ZhengXueTech/balance-toys/img/eagle-ar.jpg

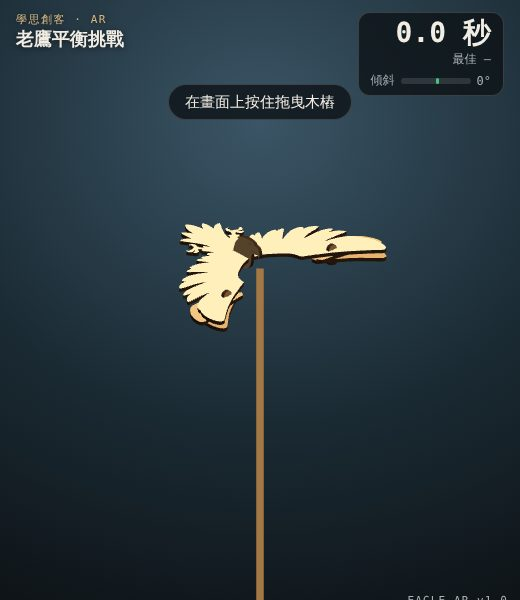
img/eagle-ar.jpg
