ZhengXueTech/balance-toys/eagle/ar_samples/eagle2_doodle.jpg

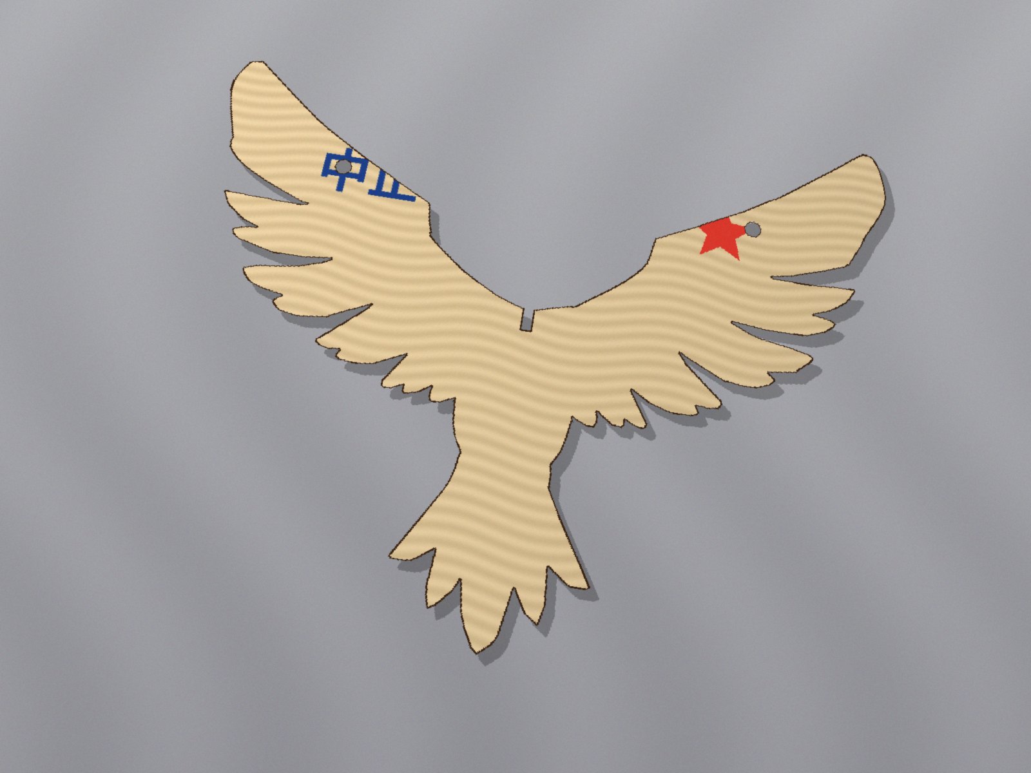
eagle/ar_samples/eagle2_doodle.jpg
