ZhengXueTech/balance-toys/eagle/ar_samples/eagle1_bald.jpg

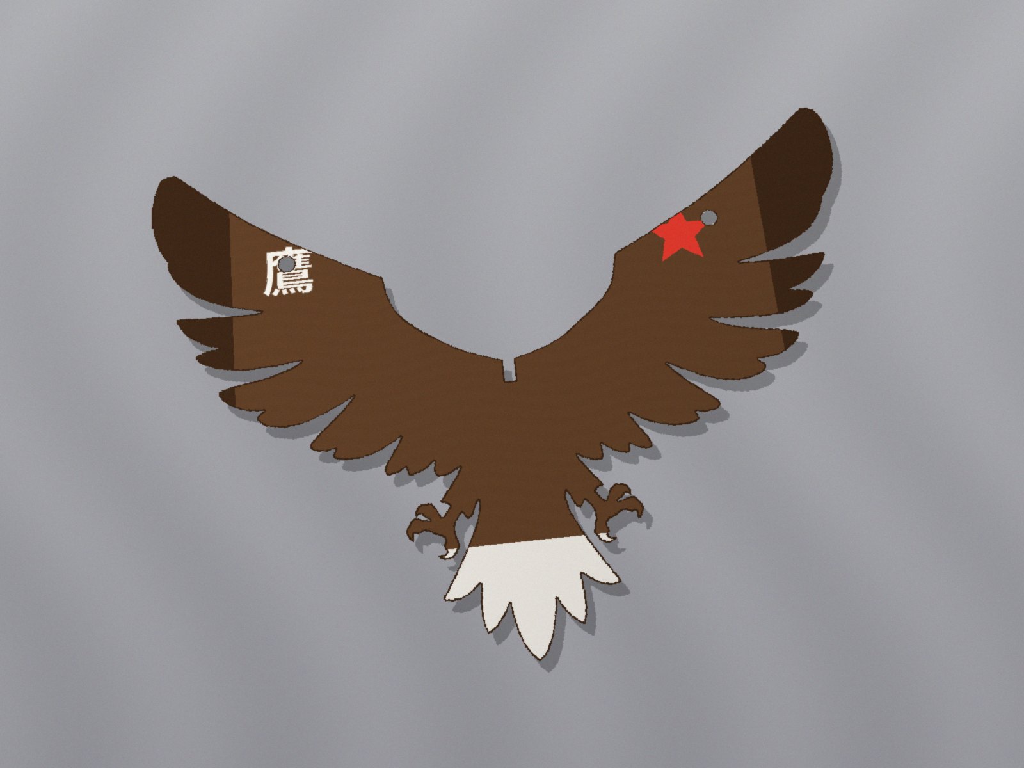
eagle/ar_samples/eagle1_bald.jpg
