ZhengXueTech/balance-toys/eagle/ar_samples/eagle1_doodle.jpg

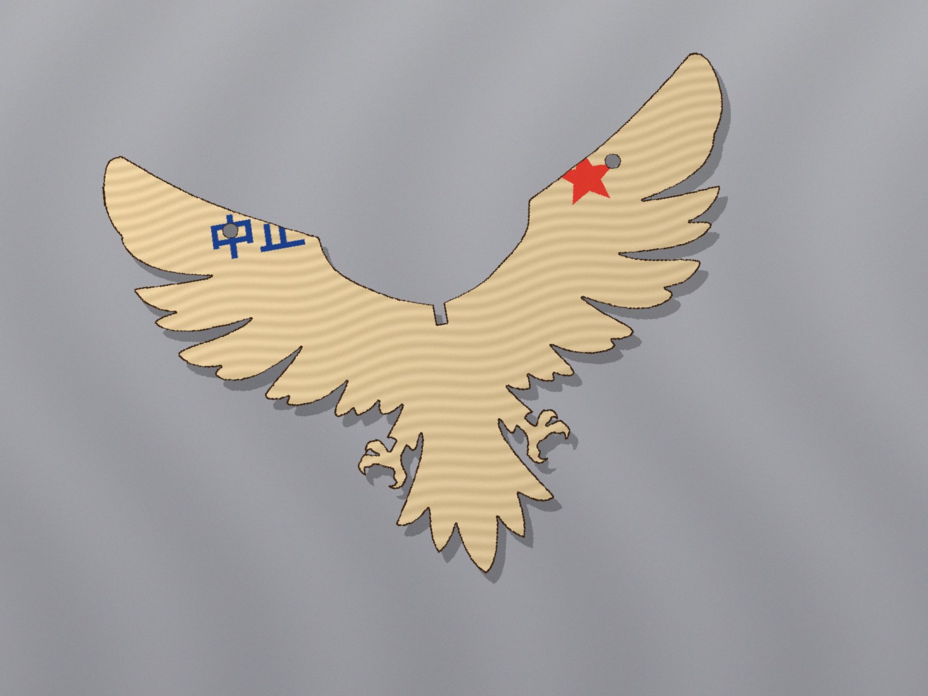
eagle/ar_samples/eagle1_doodle.jpg
