ZhengXueTech/balance-toys/eagle/ar_samples/eagle1_rainbow.jpg

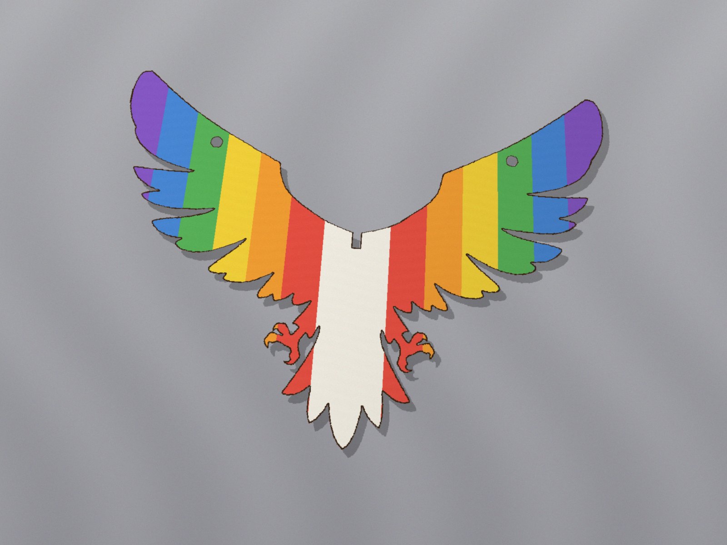
eagle/ar_samples/eagle1_rainbow.jpg
