ZhengXueTech/balance-toys/eagle/ar_samples/eagle2_magpie.jpg

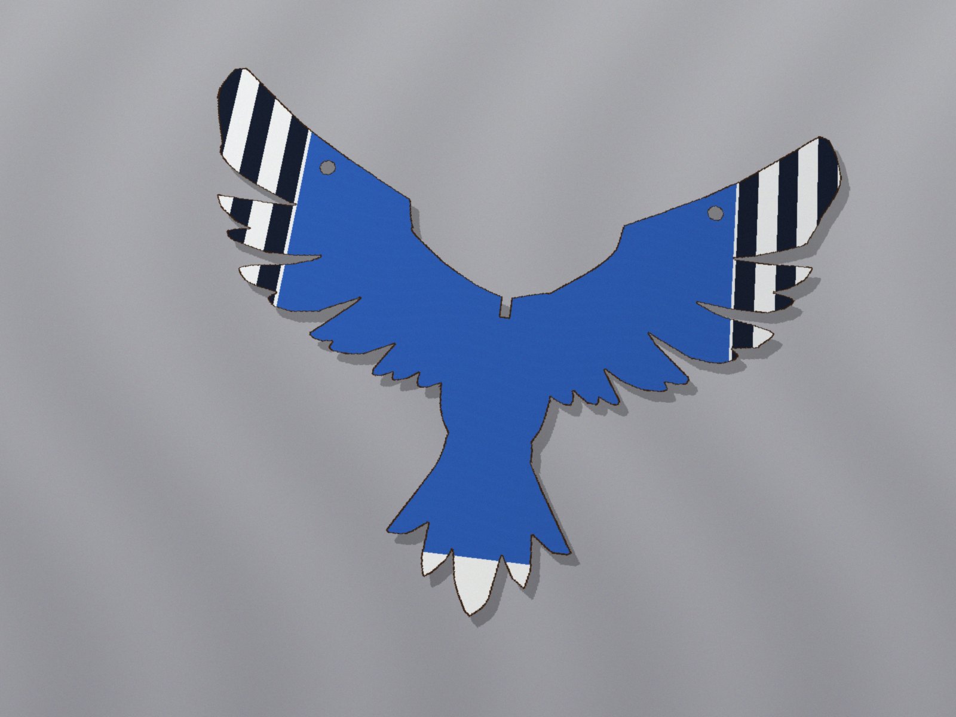
eagle/ar_samples/eagle2_magpie.jpg
