ZhengXueTech/balance-toys/eagle/ar_samples/eagle2_phoenix.jpg

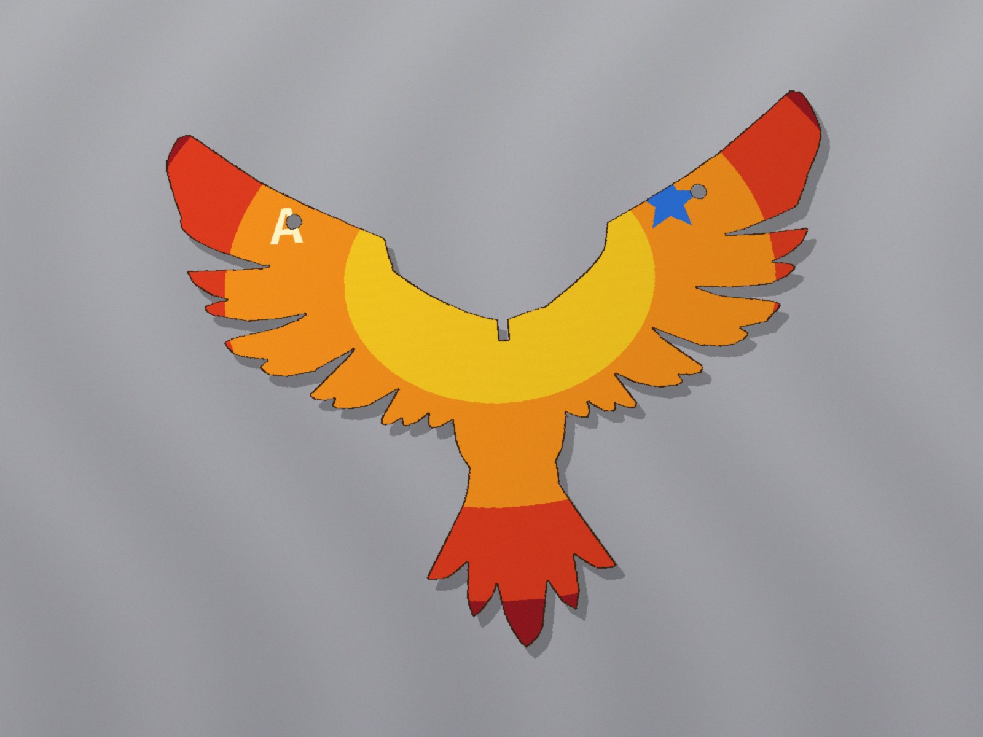
eagle/ar_samples/eagle2_phoenix.jpg
