ZhengXueTech/balance-toys/img/iss-lab.jpg

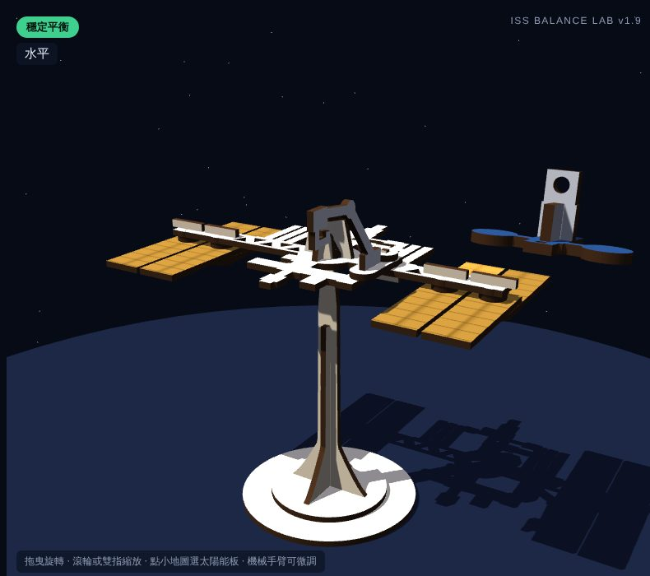
img/iss-lab.jpg
