ZhengXueTech/balance-toys/img/pelican2-lab.jpg

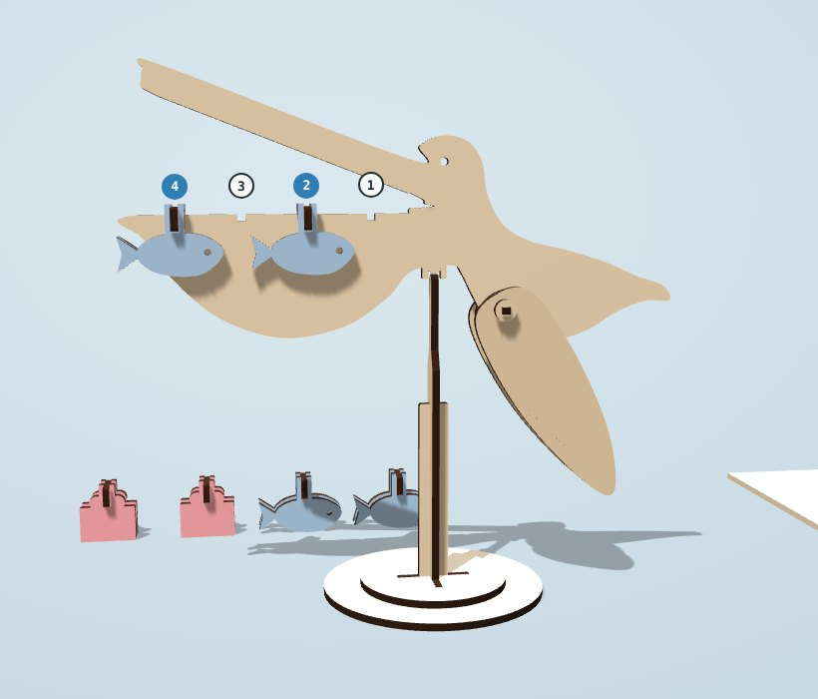
img/pelican2-lab.jpg
