ZhengXueTech/balance-toys/img/pelican-lab.jpg

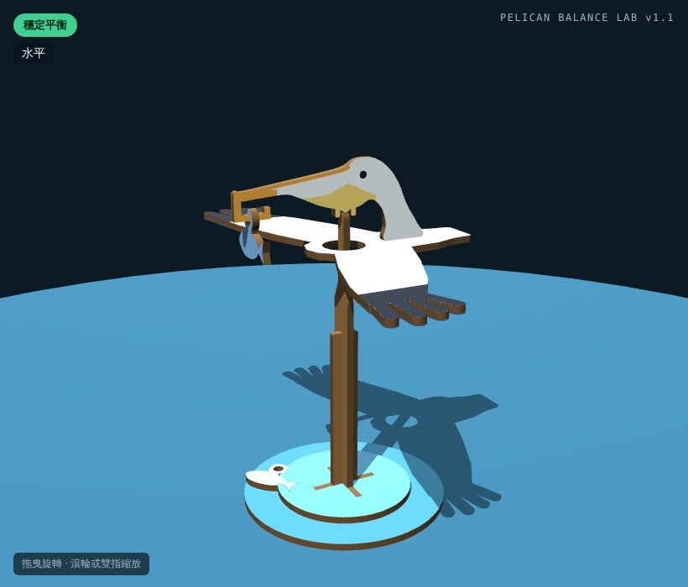
img/pelican-lab.jpg
