ZhengXueTech/balance-toys/eagle/files/Eagle2_prey_V2-5_board600x400_6sets_fishonly_laser.dxf

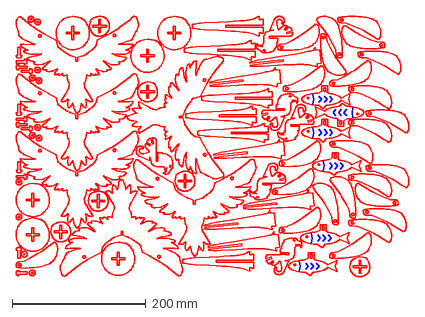
[picture p11: CAD file, 2026-11-08]
eagle/files/Eagle2_prey_V2-5_board600x400_6sets_fishonly_laser.dxf
588.4 x 389.9 mm
