ZhengXueTech/balance-toys/iss/files/ISS_v7_board600x400_4sets_laser.dxf

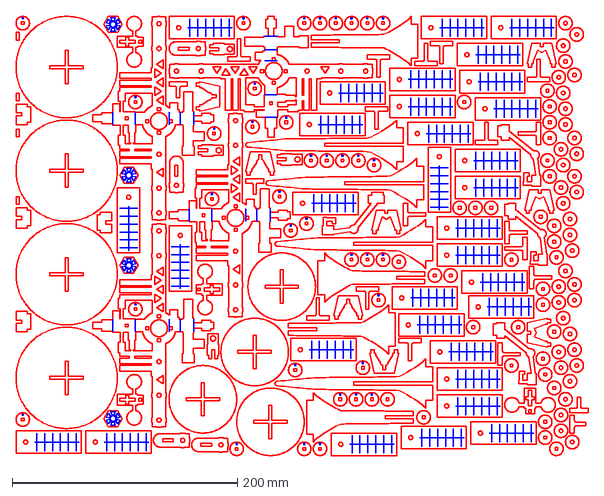
[picture p12: CAD file, 2026-11-01]
iss/files/ISS_v7_board600x400_4sets_laser.dxf
508.0 x 390.0 mm
