ZhengXueTech/balance-toys/pelican/files/Pelican2_v1.1_board600x400_4sets_laser.dxf

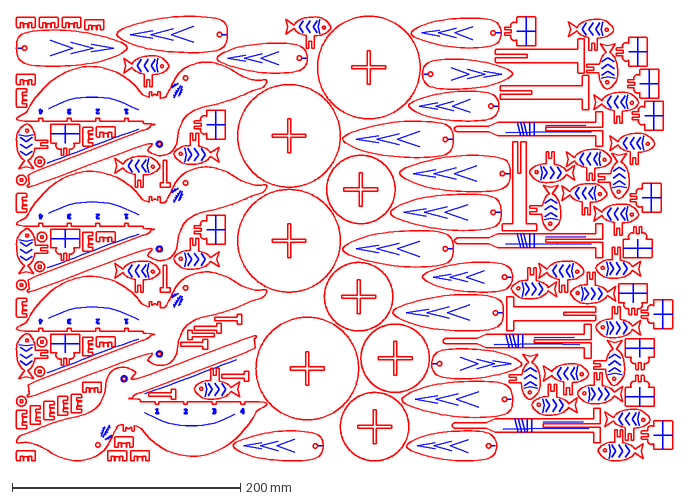
[picture p13: CAD file, 2026-11-01]
pelican/files/Pelican2_v1.1_board600x400_4sets_laser.dxf
575.2 x 390.0 mm
