ZhengXueTech/balance-toys/tools/Joint_test_comb_3mm_laser.dxf

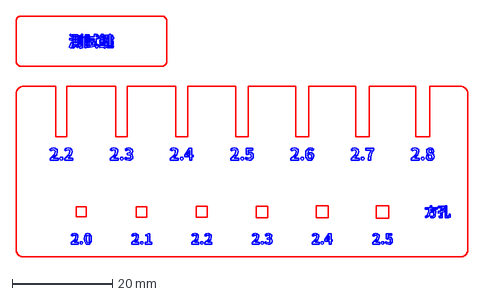
[picture p14: CAD file, 2026-11-08]
tools/Joint_test_comb_3mm_laser.dxf
90.0 x 48.0 mm
