ZhengXueTech/balance-toys/eagle/files/Eagle2_prey_V2-5_laser.dxf

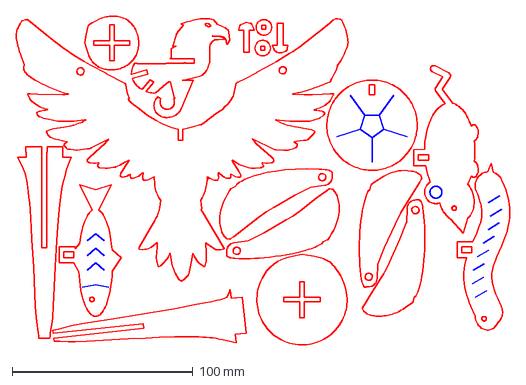
[picture p15: CAD file, 2026-11-08]
eagle/files/Eagle2_prey_V2-5_laser.dxf
272.9 x 181.7 mm
