ZhengXueTech/balance-toys/iss/files/ISS_v7_slot27_laser.dxf

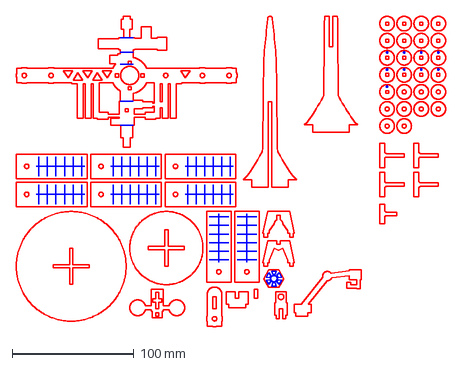
[picture p16: CAD file, 2026-10-27]
iss/files/ISS_v7_slot27_laser.dxf
352.0 x 254.5 mm
