ZhengXueTech/balance-toys/pelican/files/Pelican_v1.1_board600x400_6sets_laser.dxf

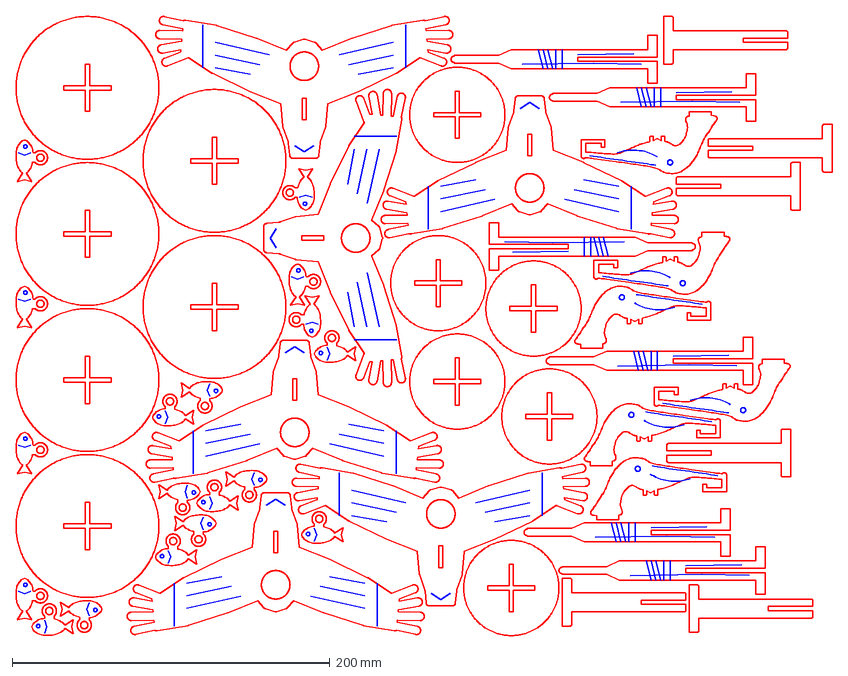
[picture p17: CAD file, 2026-11-01]
pelican/files/Pelican_v1.1_board600x400_6sets_laser.dxf
514.0 x 390.0 mm
