ZhengXueTech/balance-toys/pelican/files/Pelican2_v1.1_laser.dxf

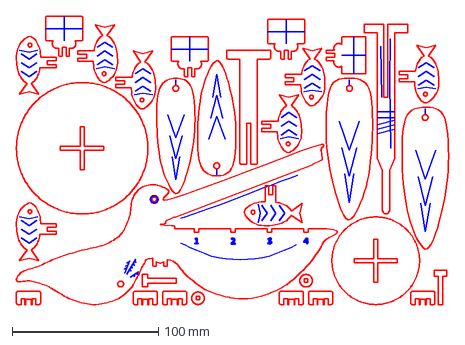
[picture p19: CAD file, 2026-11-01]
pelican/files/Pelican2_v1.1_laser.dxf
295.8 x 197.2 mm
