ZhengXueTech/balance-toys/eagle/files/Eagle2_prey_V2-4_board600x400_5sets_laser.dxf

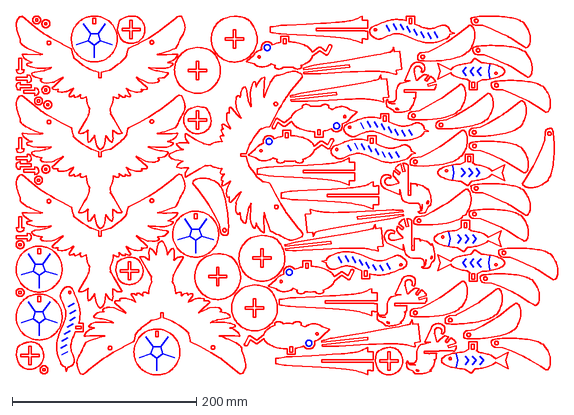
[picture p21: CAD file, 2026-11-01]
eagle/files/Eagle2_prey_V2-4_board600x400_5sets_laser.dxf
588.4 x 389.9 mm
