ZhengXueTech/balance-toys/pelican/files/Pelican_v1.1_slot27_laser.dxf

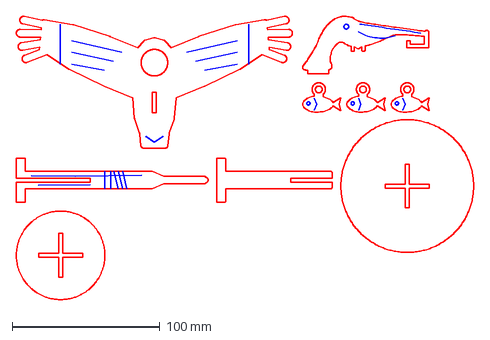
[picture p22: CAD file, 2026-10-27]
pelican/files/Pelican_v1.1_slot27_laser.dxf
310.0 x 192.0 mm
