ZhengXueTech/balance-toys/eagle/files/Eagle2_prey_V2-4_laser.dxf

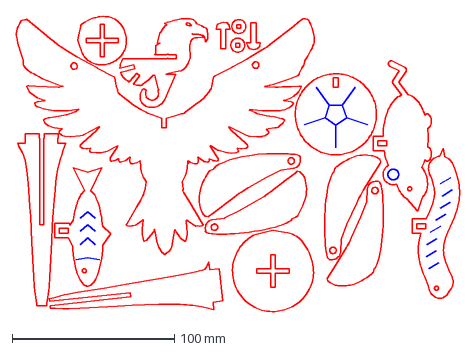
[picture p23: CAD file, 2026-10-29]
eagle/files/Eagle2_prey_V2-4_laser.dxf
272.9 x 181.7 mm
