ZhengXueTech/balance-toys/pelican/files/Pelican2_v1.0_laser.dxf

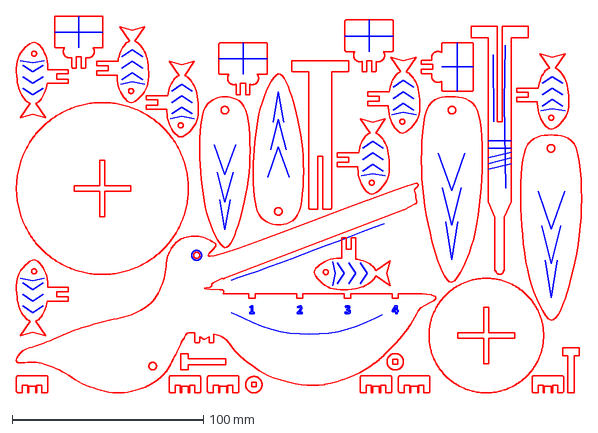
[picture p24: CAD file, 2026-11-01, an earlier design]
pelican/files/Pelican2_v1.0_laser.dxf
295.8 x 197.2 mm
