ZhengXueTech/balance-toys/eagle/files/Eagle2_prey_V2-5_cardboard_A3.pdf

## 老鷹平衡鳥 第二款 V2_5（卡榫再收緊）「老鷹抓獵物」（3 mm 板，老鷹 14 片＋獵物 4 片，全木頭）

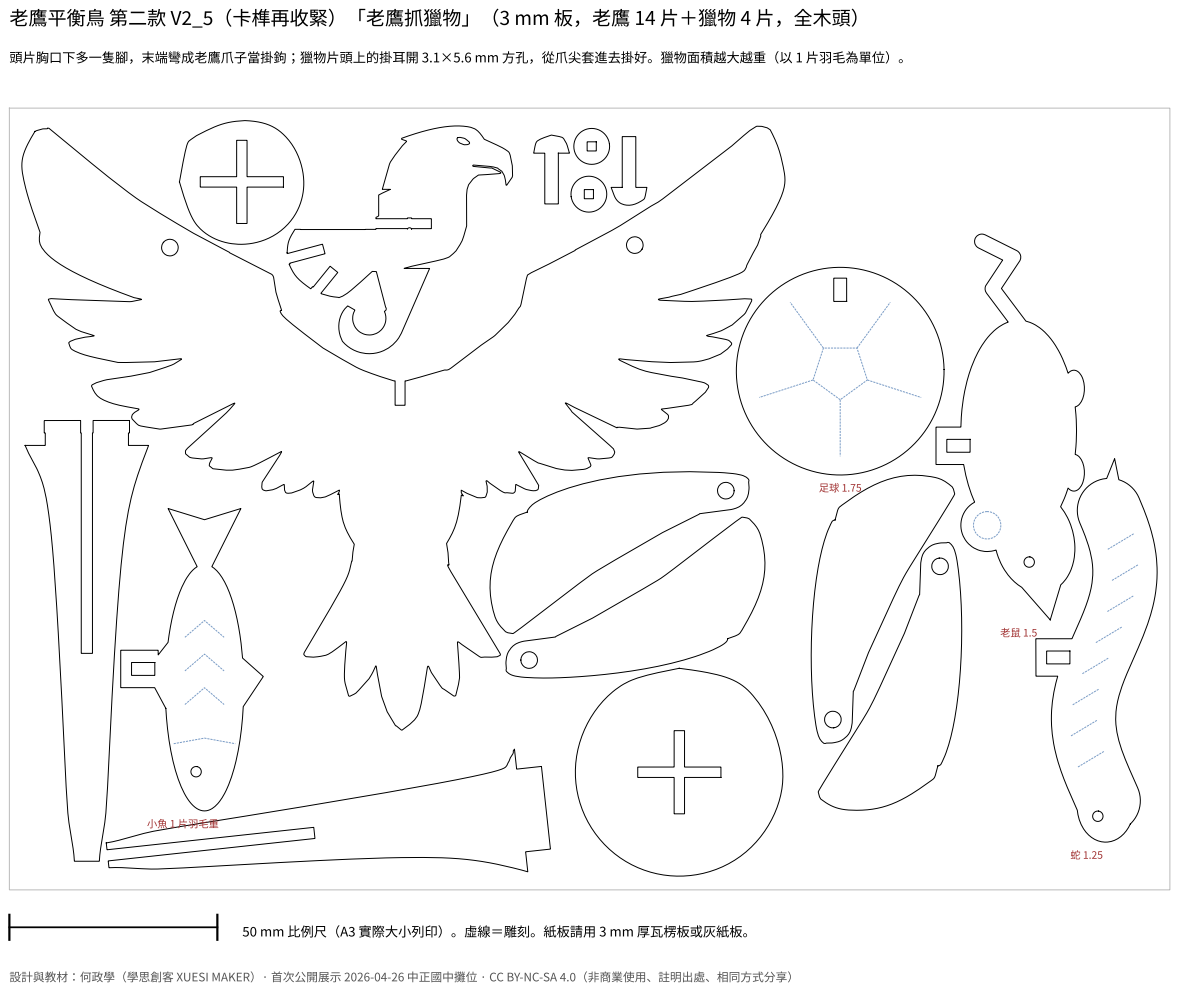
[picture p25: page 1]
小魚 1 片羽毛重

頭片胸口下多一隻腳，末端彎成老鷹爪子當掛鉤；獵物片頭上的掛耳開 3.1×5.6 mm 方孔，從爪尖套進去掛好。獵物面積越大越重（以 1 片羽毛為單位）。

50 mm 比例尺（A3 實際大小列印）。虛線＝雕刻。紙板請用 3 mm 厚瓦楞板或灰紙板。

設計與教材：何政學（學思創客 XUESI MAKER）· 首次公開展示 2026-04-26 中正國中攤位 · CC BY-NC-SA 4.0（非商業使用、註明出處、相同方式分享）
