ZhengXueTech/balance-toys/pelican/files/Pelican2_v1.1_cardboard_A3.pdf

## 鵜鶘平衡鳥 第二款 v1.1（張嘴鵜鶘：下巴支點、喉囊 4 格掛 H 形魚或禮物、翅膀可轉；肩膀前上方 3 根小羽毛＝翅膀角度記號）

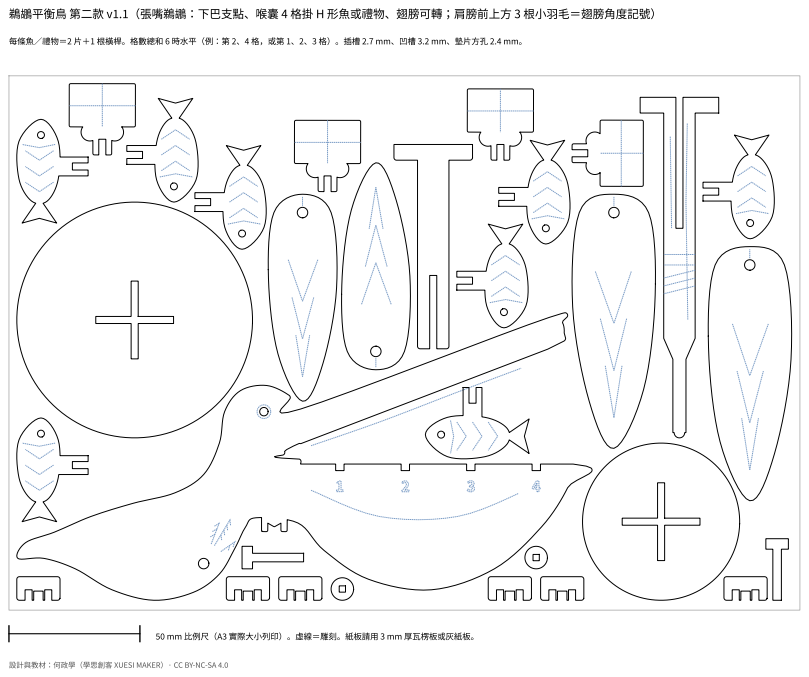
[picture p26: page 1]

每條魚／禮物＝2 片＋1 根橫桿。格數總和 6 時水平（例：第 2、4 格，或第 1、2、3 格）。插槽 2.7 mm、凹槽 3.2 mm、墊片方孔 2.4 mm。

50 mm 比例尺（A3 實際大小列印）。虛線＝雕刻。紙板請用 3 mm 厚瓦楞板或灰紙板。

設計與教材：何政學（學思創客 XUESI MAKER）· CC BY-NC-SA 4.0
