ZhengXueTech/balance-toys/iss/files/ISS_v7_slot27_cardboard_A3.pdf

## 太空站平衡玩具 v7 卡榫修正版（插槽 2.7 mm）（木插銷／M3 尼龍螺絲皆可）（3mm 板，桁架 18 cm，共 53 片）

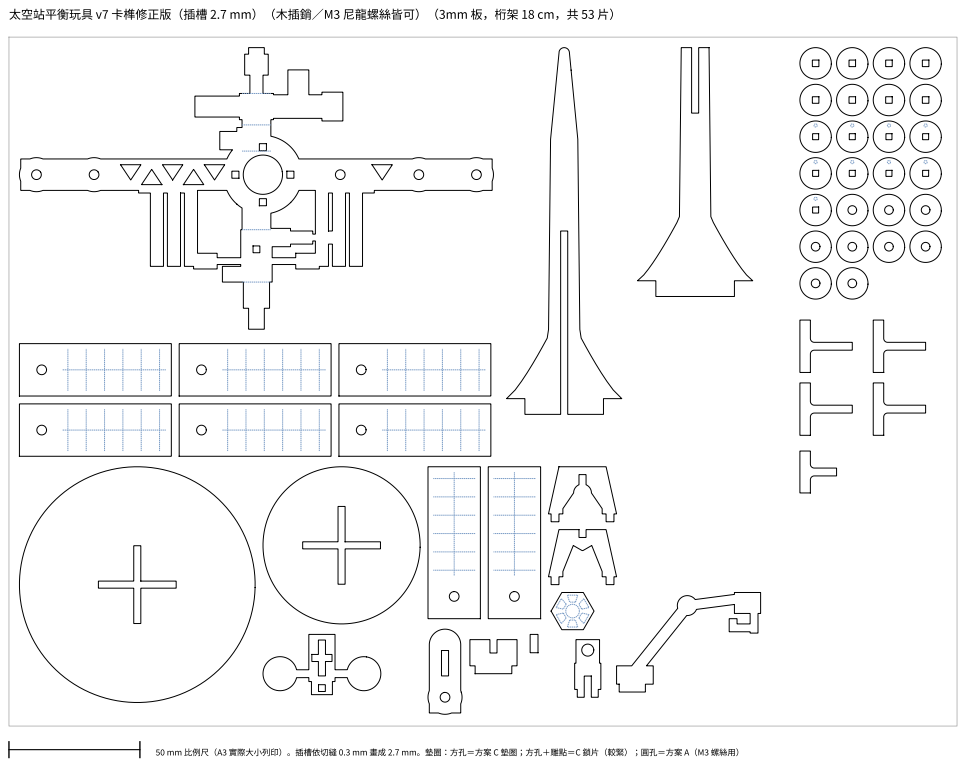
[picture p27: page 1]

50 mm 比例尺（A3 實際大小列印）。插槽依切縫 0.3 mm 畫成 2.7 mm。墊圈：方孔＝方案 C 墊圈；方孔＋雕點＝C 鎖片（較緊）；圓孔＝方案 A（M3 螺絲用）
