ZhengXueTech/balance-toys/pelican/files/Pelican_v1.1_slot27_cardboard_A3.pdf

## 鵜鶘平衡鳥 v1.1（插槽 2.7 mm，3 mm 板，翼展 187 mm，共 9 片）：喉囊夾叉坐在木樁圓頂上，嘴尖掛 1 條魚時水平

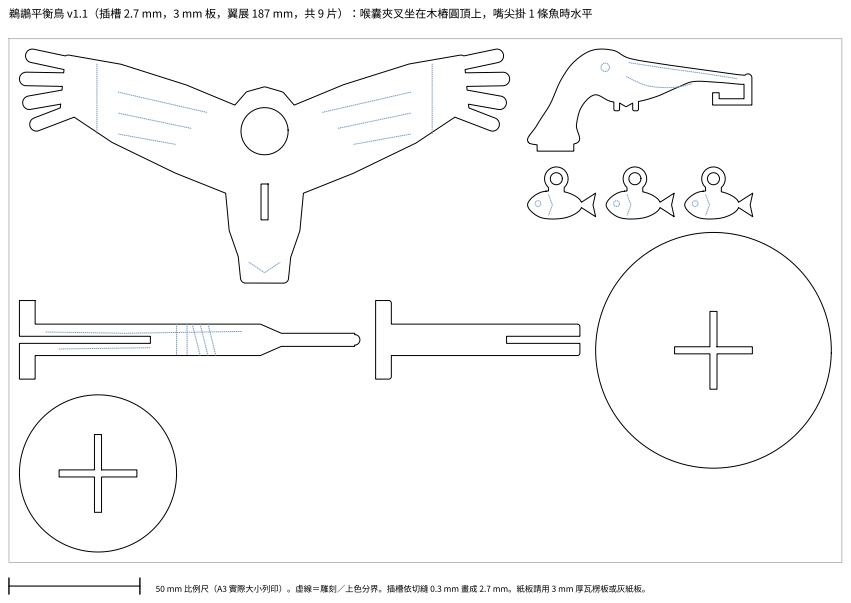
[picture p28: page 1]

50 mm 比例尺（A3 實際大小列印）。虛線＝雕刻／上色分界。插槽依切縫 0.3 mm 畫成 2.7 mm。紙板請用 3 mm 厚瓦楞板或灰紙板。
