ZhengXueTech/balance-toys/img/eagle-assembly.jpg

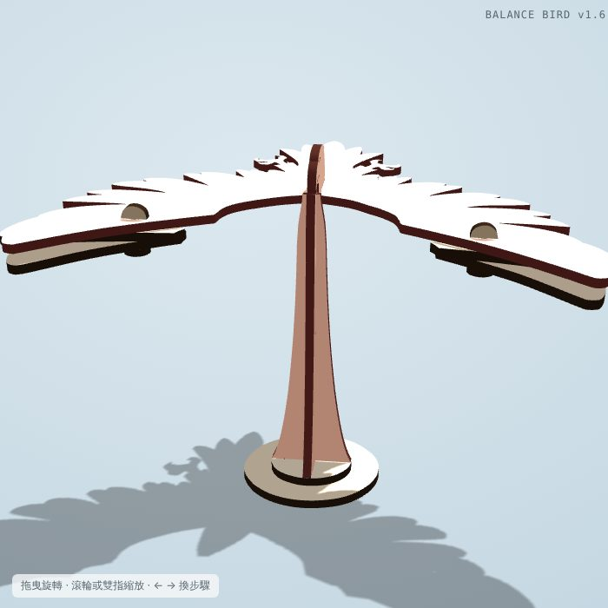
img/eagle-assembly.jpg
